fdreshaj/PCB_DESIGN_WORKSHOP_STM32/layout.pdf

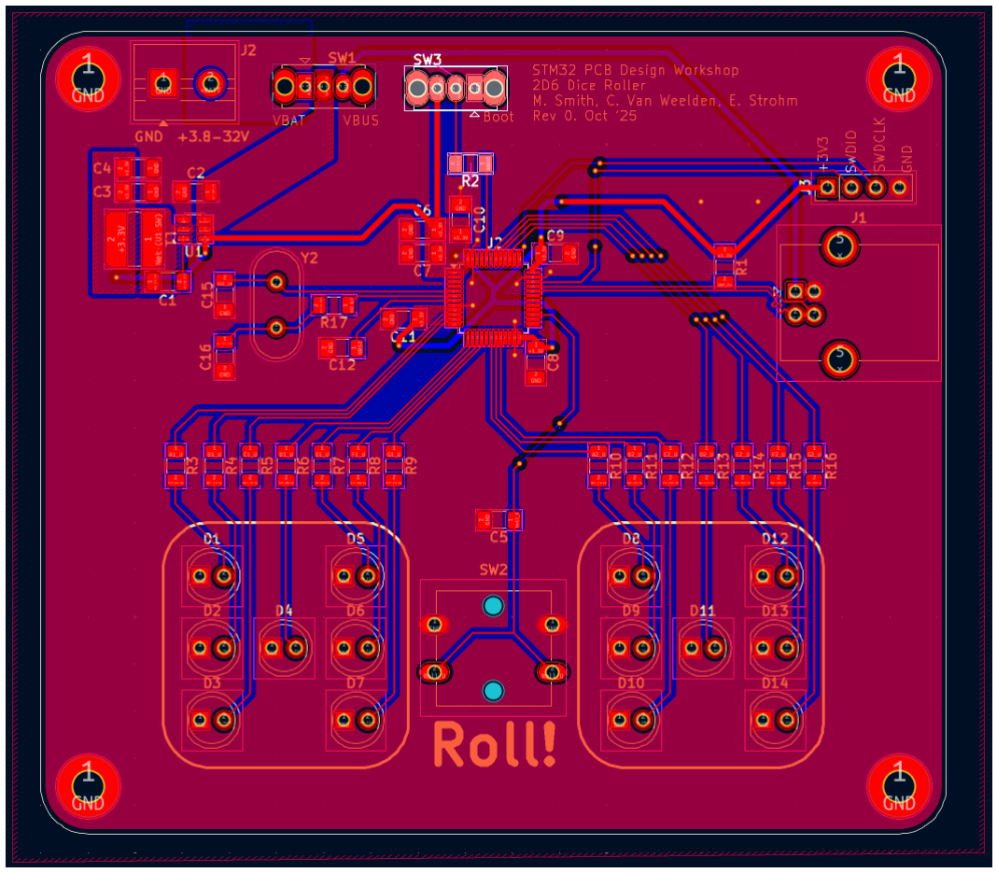
[picture p1: figure]
