fdreshaj/PCB_DESIGN_WORKSHOP_STM32/Layout Reference Guide Updated (1).pdf

# Layout Reference Guide

Before moving onto layout, make sure all your symbols have an assigned footprint.

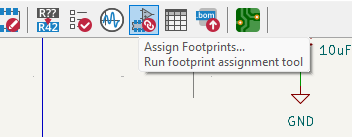
[picture p2: figure]

Your Assignments should look something similar to this, a symbol should have a matching footprint, check the given STM32_PCB_Workshop_Design.xlsx for finding
the right footprints. You should not need to import any symbol or footprint for this project.

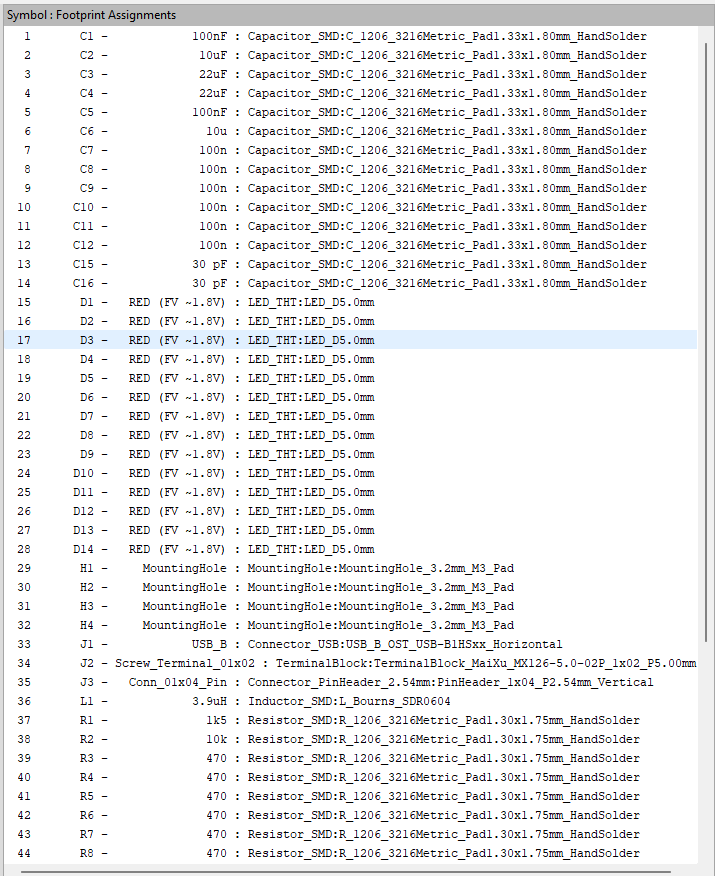
[picture p3: figure]

When you go through assigning footprints, make sure you are copying the footprint associated with the right value instead of the Reference number, since your placement might have different numbers.

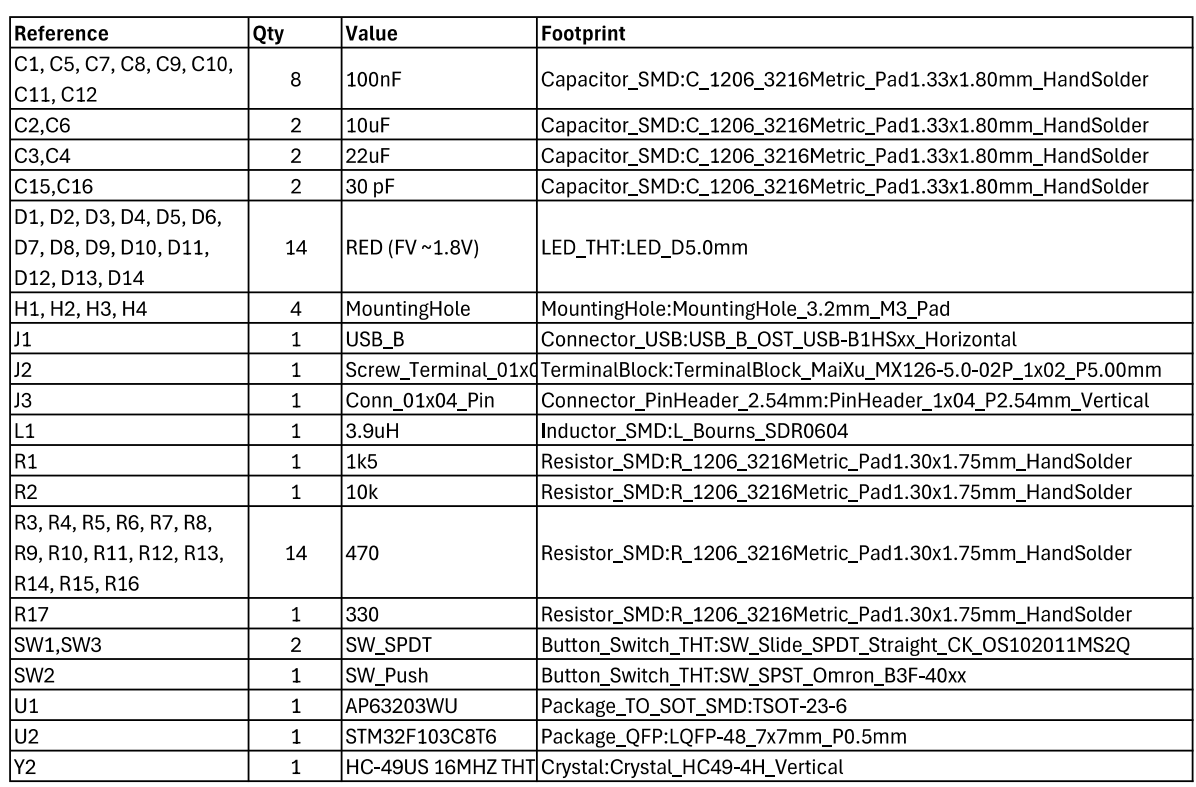
[picture p4: figure]
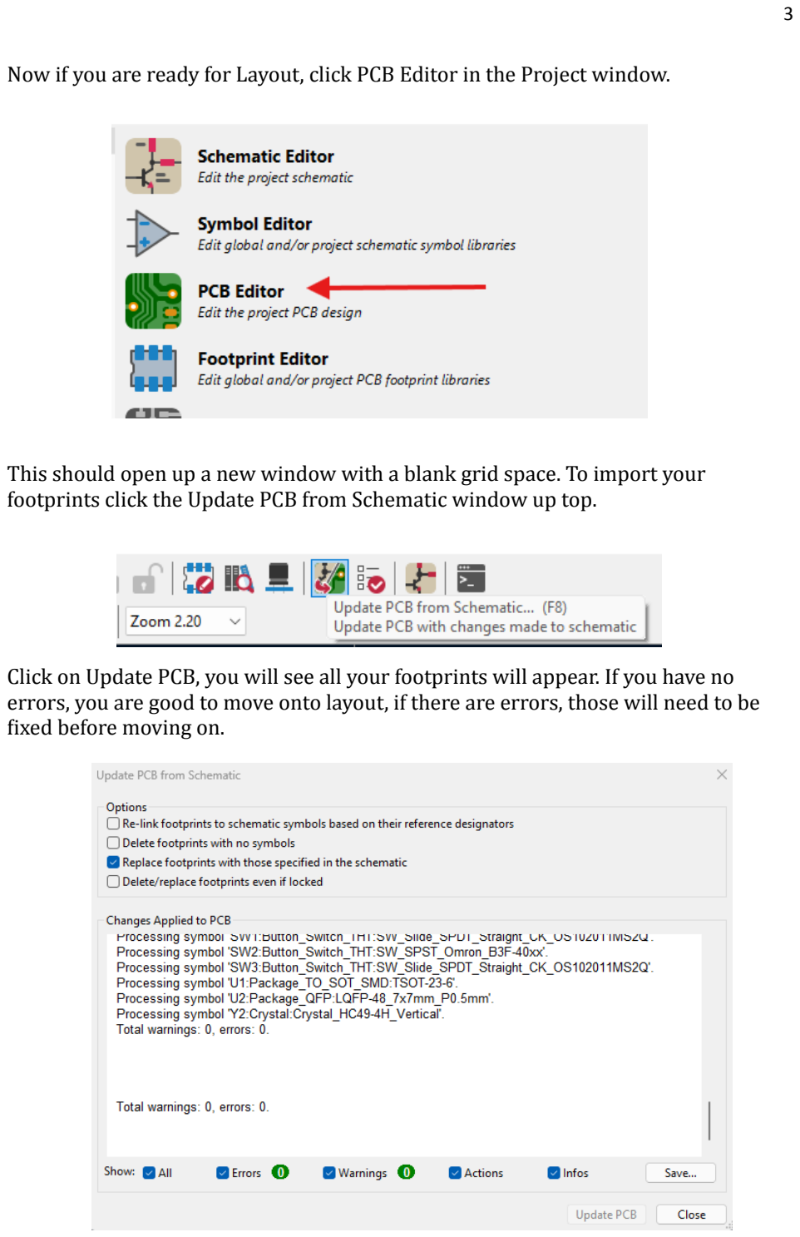
[picture p5: page 3]

Now if you are ready for Layout, click PCB Editor in the Project window.

This should open up a new window with a blank grid space. To import your footprints click the Update PCB from Schematic window up top.

Click on Update PCB, you will see all your footprints will appear. If you have no errors, you are good to move onto layout, if there are errors, those will need to be fixed before moving on.

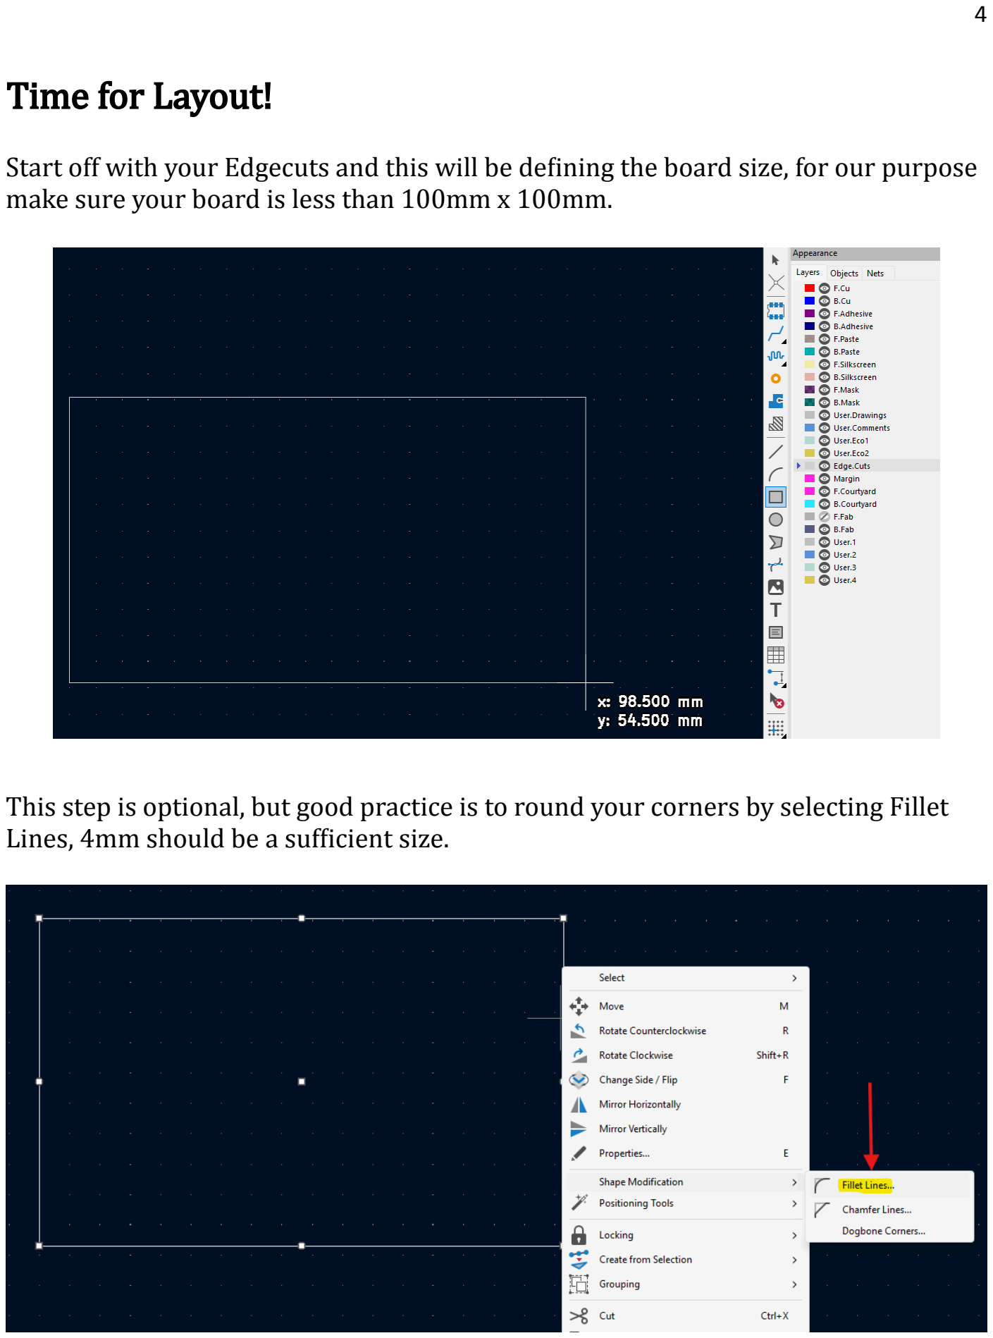
[picture p6: page 4]

Time for Layout!

Start off with your Edgecuts and this will be defining the board size, for our purpose make sure your board is less than 100mm x 100mm.

This step is optional, but good practice is to round your corners by selecting Fillet Lines, 4mm should be a sufficient size.

One last thing before we start connecting all of our components is to either define your netclasses or make Pre-defined Sizes. The point of this is to set what our trace widths need to be for certain connections, for most signal lines, having the default value of 0.2mm will be sufficient. However for power sections, or areas with a high amount of current flowing through we want thicker traces.

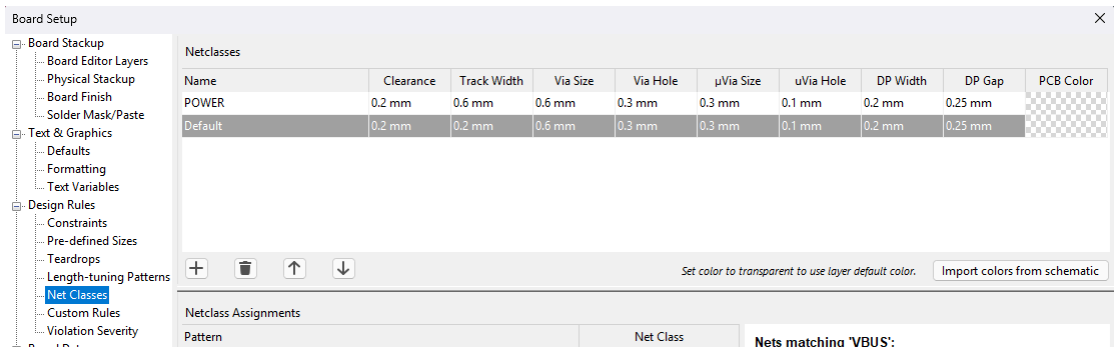
[picture p7: figure]
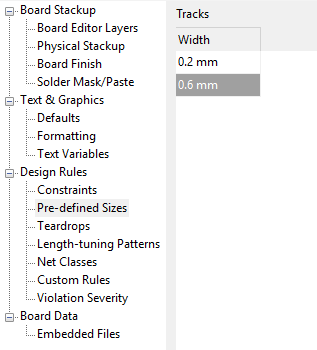
[picture p8: figure]
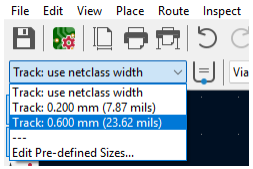
[picture p9: figure]

If you are interested in knowing the exact value to choose for trace widths, DigiKey
has a calculator reference: PCB Trace Width Conversion Calculator | DigiKey (https://www.digikey.com/en/resources/conversion-calculators/conversion-calculator-pcb-trace-width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)

General rule of thumb is go as thick as you can for known high current traces.

Reference Layout

At this point, you have the freedom of laying out the components however you would like. There are some general guidelines in layout we recommend to prevent signal integrity issues, performance, and easier chance of soldering components(keep in mind you will end up soldering these components yourself, make your job as easy as possible)

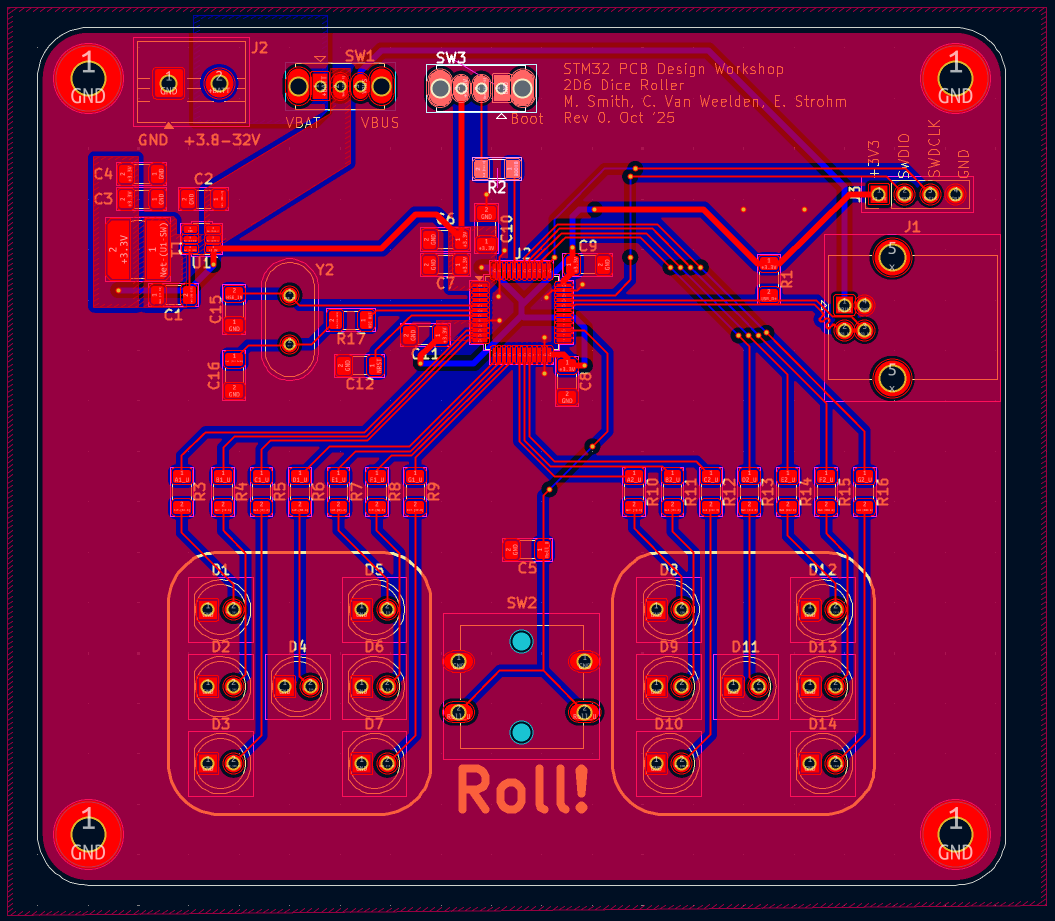
[picture p10: figure]

If unsure where to start placing components. Here is our reference design to get started.

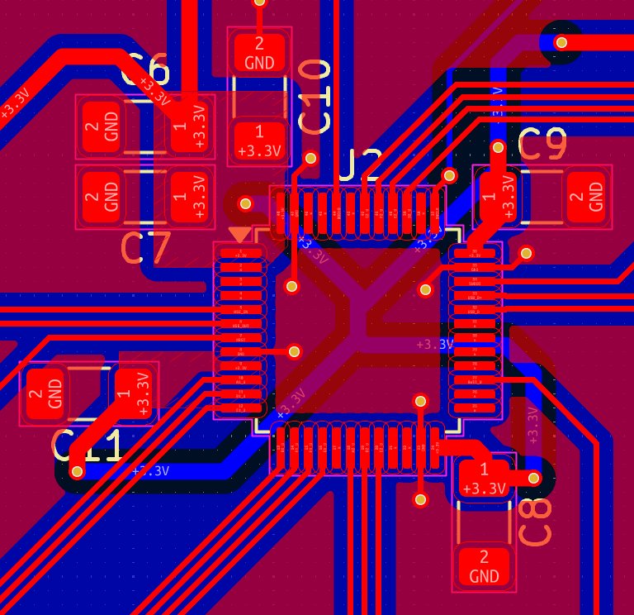
[picture p11: figure]

In most designs, you want to start off with your MCU(Micro Controller Unit) in our case is the STM32 board. This will usually be in the center of the board for options in routing our signal lines. Make sure your decoupling caps (C6,C7,C8,C9,C10,C11) are close to the +3.3V lines of your MCU.

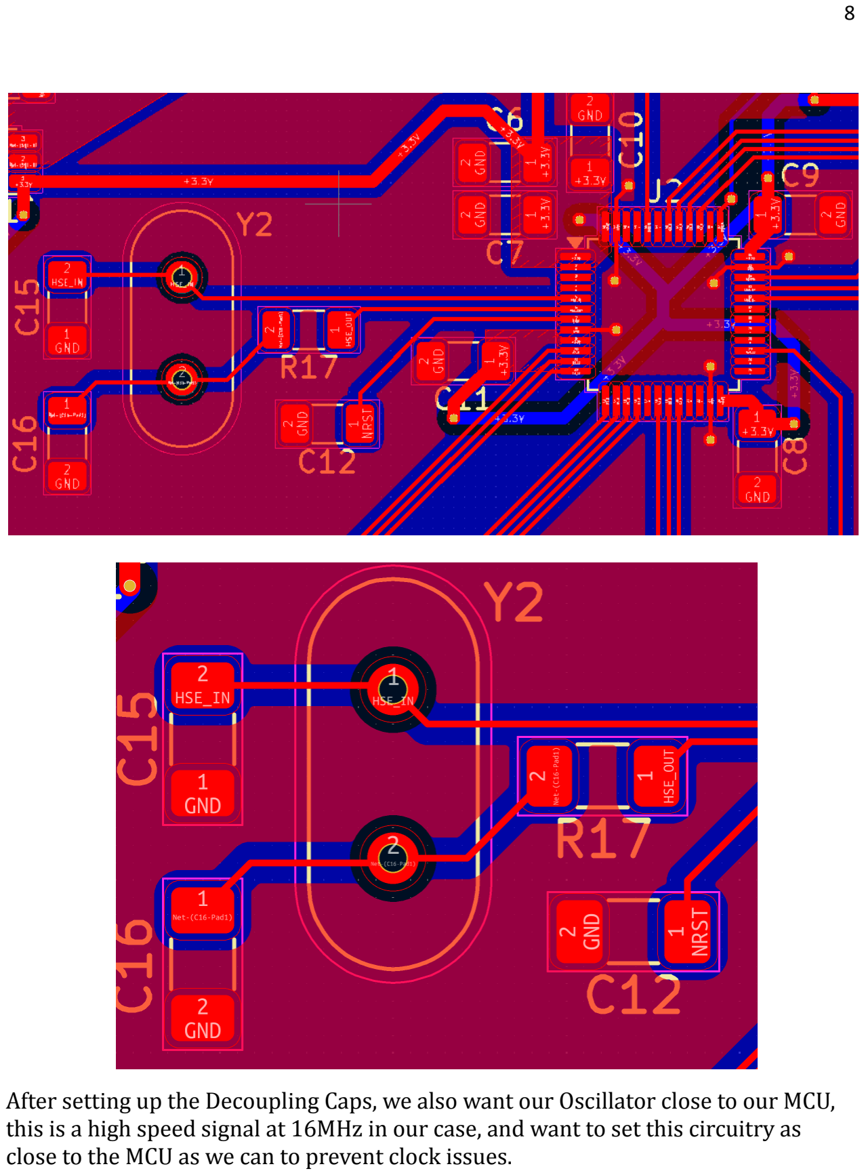
[picture p12: page 8]

After setting up the Decoupling Caps, we also want our Oscillator close to our MCU, this is a high speed signal at 16MHz in our case, and want to set this circuitry as close to the MCU as we can to prevent clock issues.

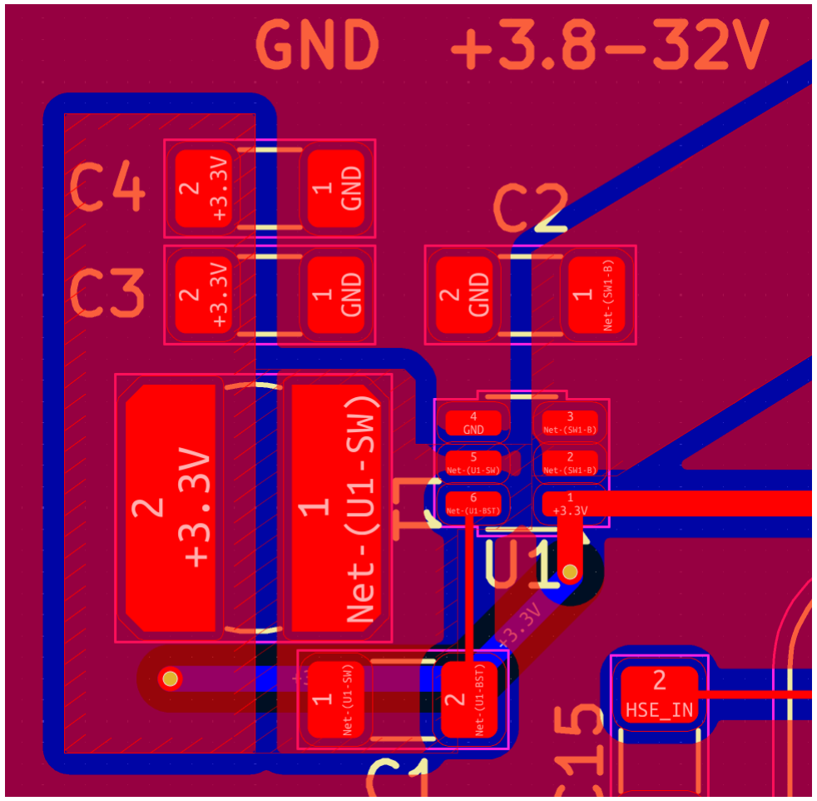
[picture p13: figure]

Next we can set up the Switching Regulator, again, this layout is based on this recommended datasheet layout from AP63203WU. Something to note is that this Switching regulator is switching around 1.1MHZ and should be put further away from the crystal oscillator if you can or other high speed circuitry.

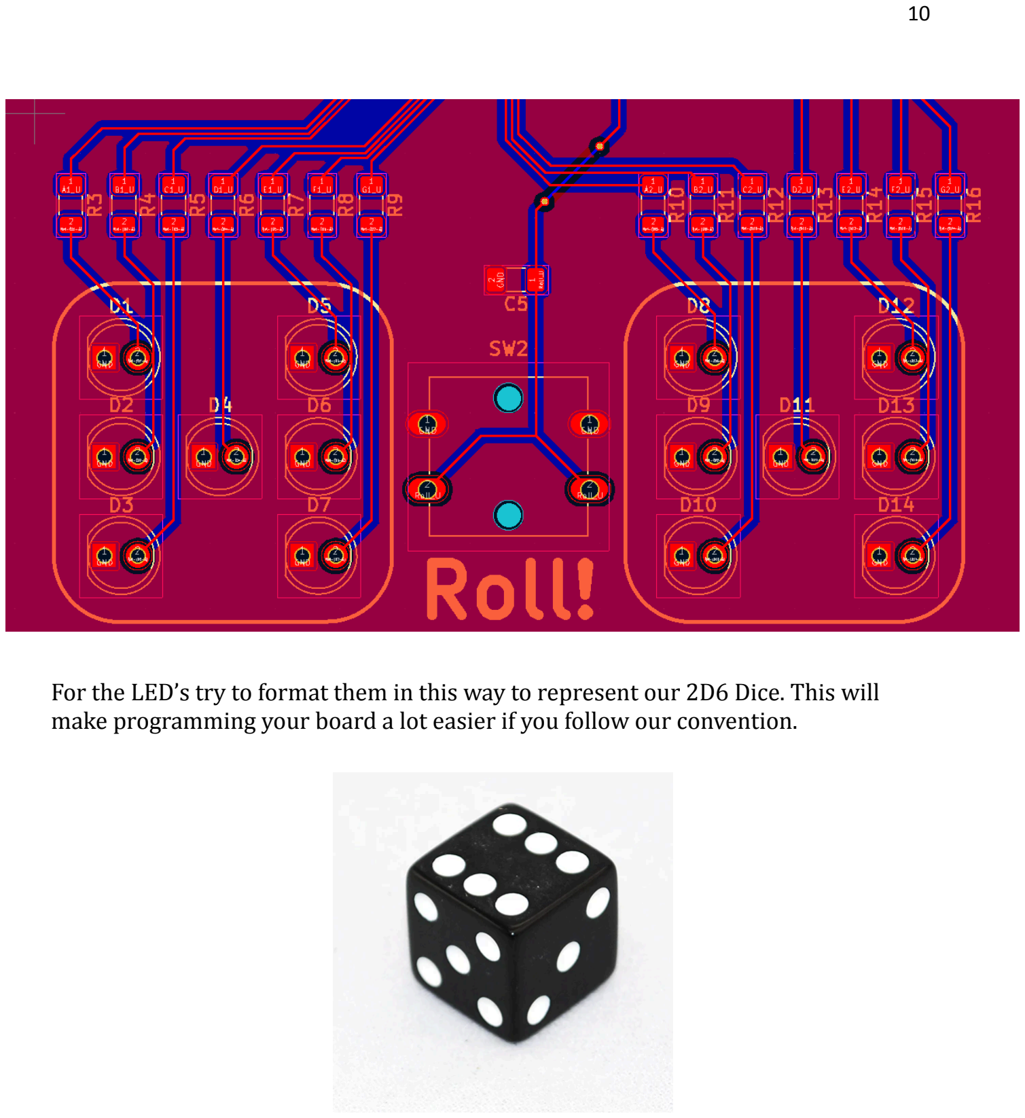
[picture p14: page 10]

For the LED’s try to format them in this way to represent our 2D6 Dice. This will make programming your board a lot easier if you follow our convention.

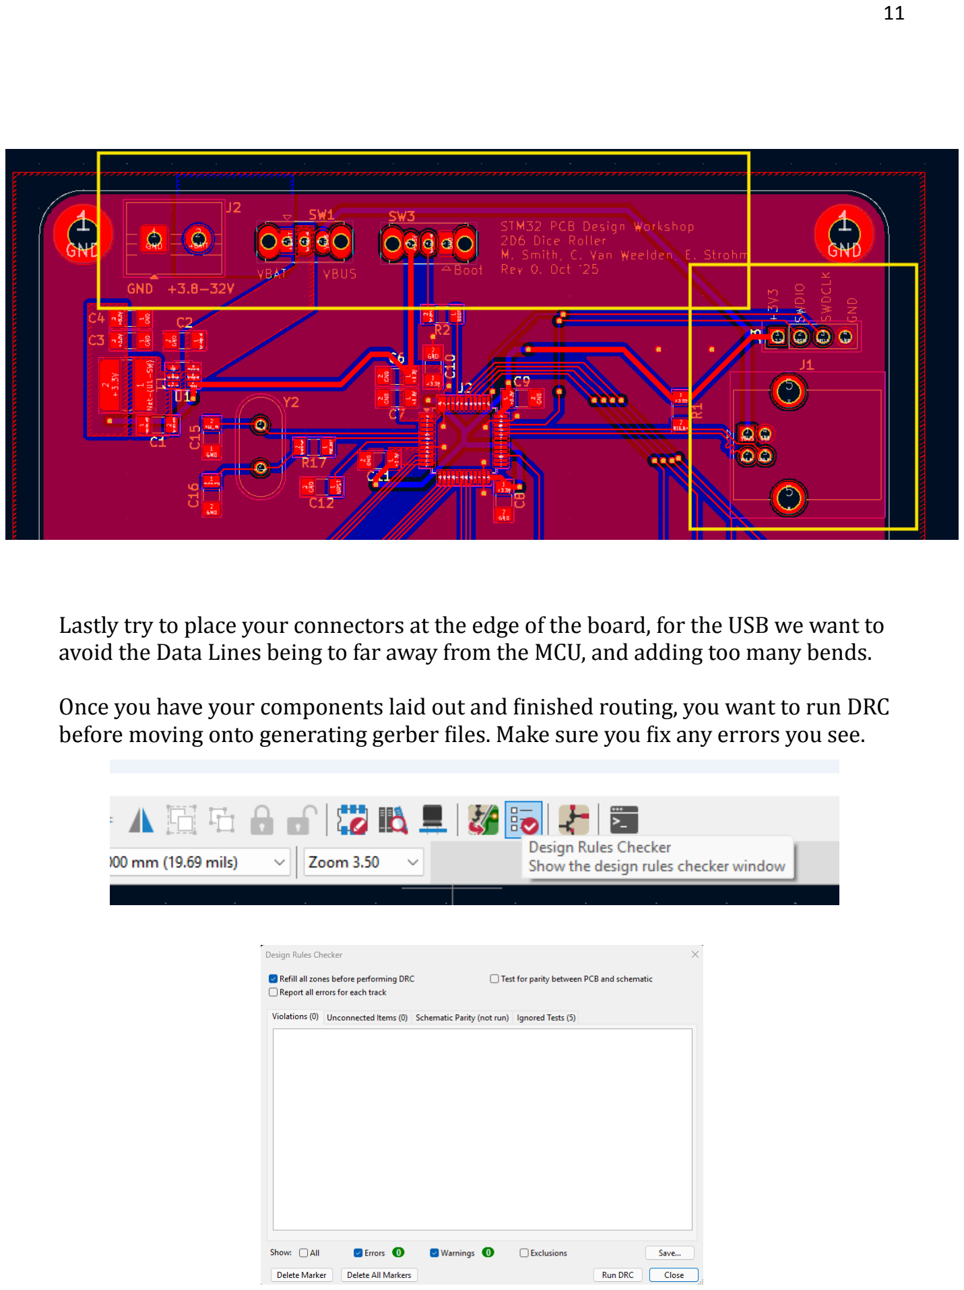
[picture p15: page 11]

Lastly try to place your connectors at the edge of the board, for the USB we want to avoid the Data Lines being to far away from the MCU, and adding too many bends.

Once you have your components laid out and finished routing, you want to run DRC before moving onto generating gerber files. Make sure you fix any errors you see.

Silk Screen

Once you have all of your routing and electrical connections made, the next step includes adding text to your board and notify important connections. This is done through the silkscreen which will appear on the top of your board, make sure when you are getting ready to add text you select the silkscreen tab. Shown below

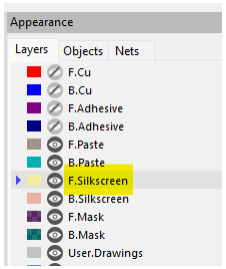
[picture p16: figure]
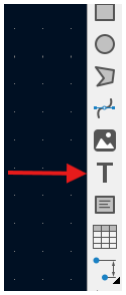
[picture p17: figure]

The silkscreen layer will appear as the yellow text in your PCB editor. Feel free to add any text or design that you would like, but make sure you have the following labeled.

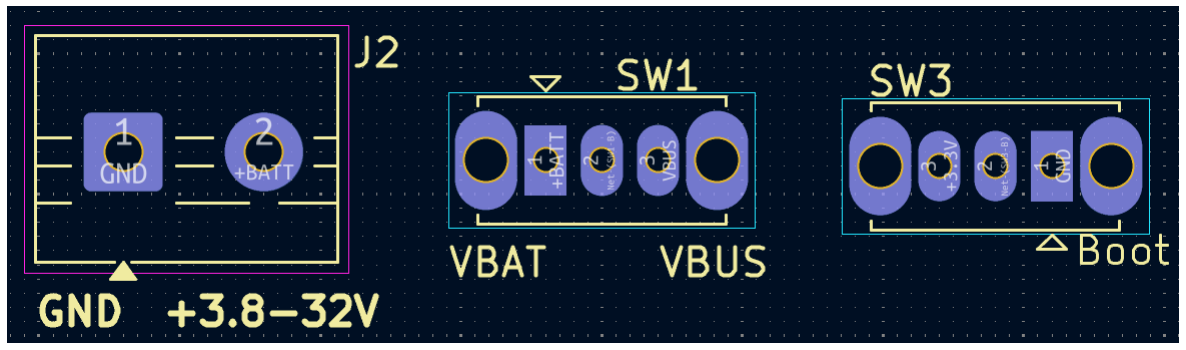
[picture p18: figure]

Make sure to include the polarity of 9V battery terminal shown in J2 symbol, adding this prevents easy mistakes of reverse polarity issues when board is finally assembled

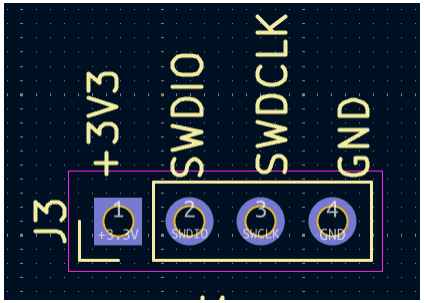
[picture p19: figure]

The other important component is to label the SWD pinout shown above.

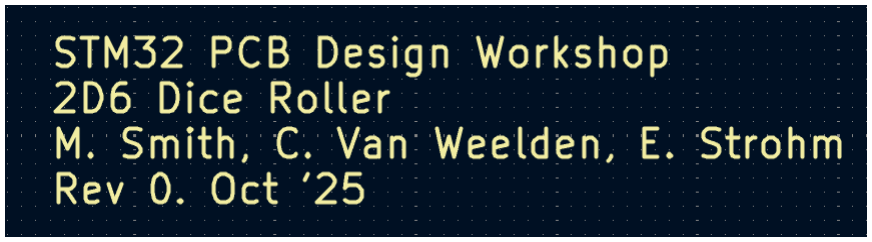
[picture p20: figure]

Lastly make sure to include the title of your board and your name to show off at future career fairs!

Gerber File & Submission:

Now that your board has passed ERC and DRC without any issues, we can move onto fabricating your board! Click on File -> Fabrication Outputs -> Gerbers. This will take you to a window, I would recommend following the layout shown in the figure below and Generate your Drill Files and Gerbers in the Same Folder

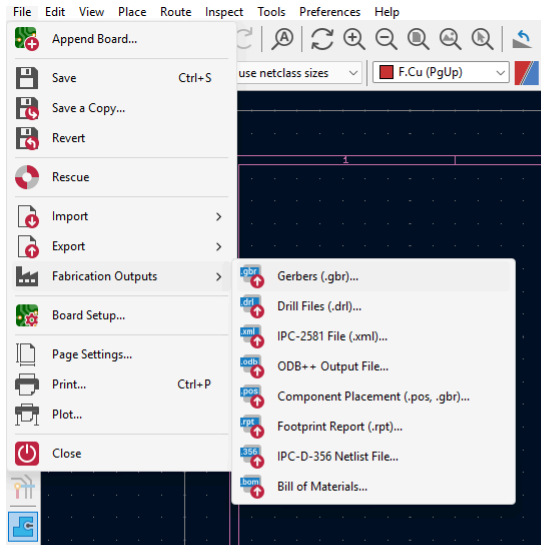
[picture p21: figure]
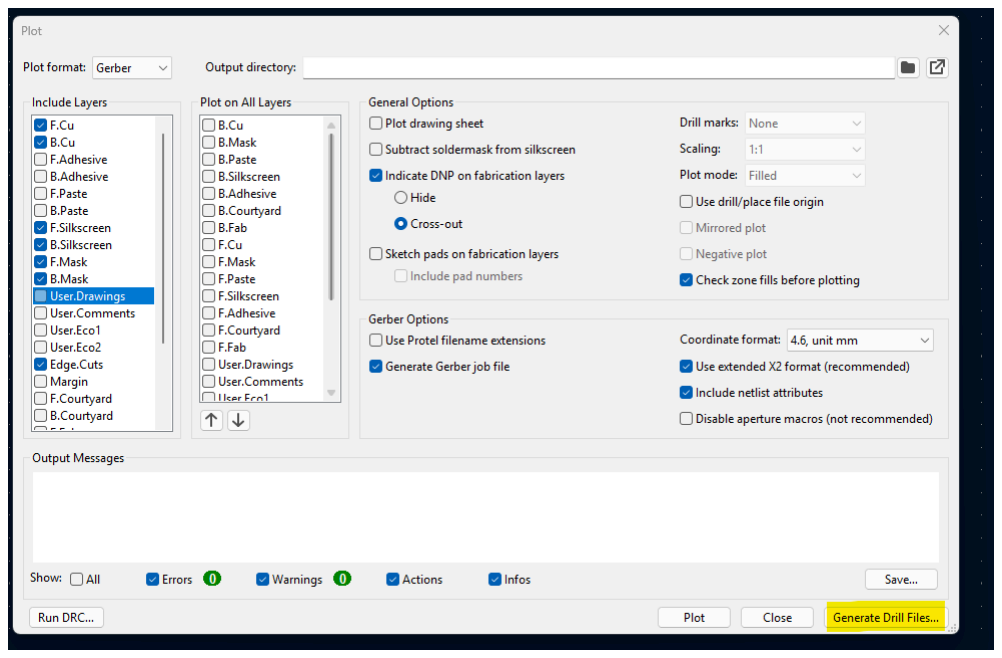
[picture p22: figure]

For your board to be fabricated We need a Zip file from you and should include the following:
- Your KiCAD Project with your Schematic(kicad_sch) and Layout(kicad_pcb)
- Your Gerber and Drill Files
- Title your Zip Folder your First and Last Name

Email your zip file to mss3247@iastate.edu
