fdreshaj/PCB_DESIGN_WORKSHOP_STM32/STM32_PCB_Workshop_Design/STM32_PCB_Workshop_Design.pdf

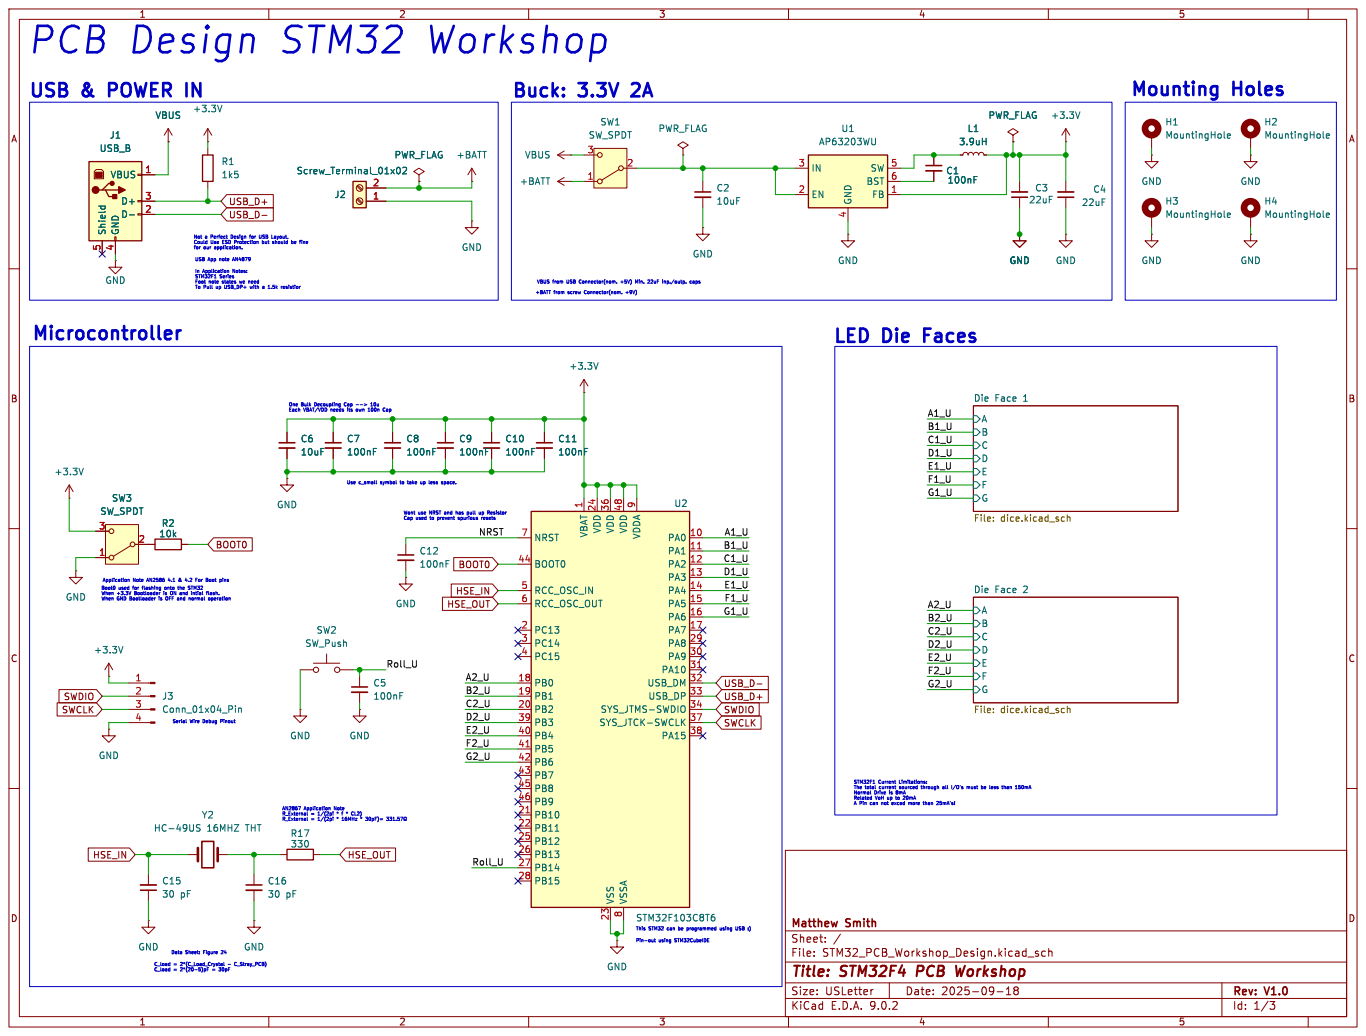
[picture p23: page 1]

4 SW 5 BST 6 FB 1 U1 AP63203WU GND

Die Face 1 File: dice.kicad_sch C2

1 VDD 24 VDD 36 VSS 23 VDD 48 VSSA
NRST E2_U

File: STM32_PCB_Workshop_Design.kicad_sch Sheet: / Matthew Smith

Id: 1/3 Title: STM32F4 PCB Workshop

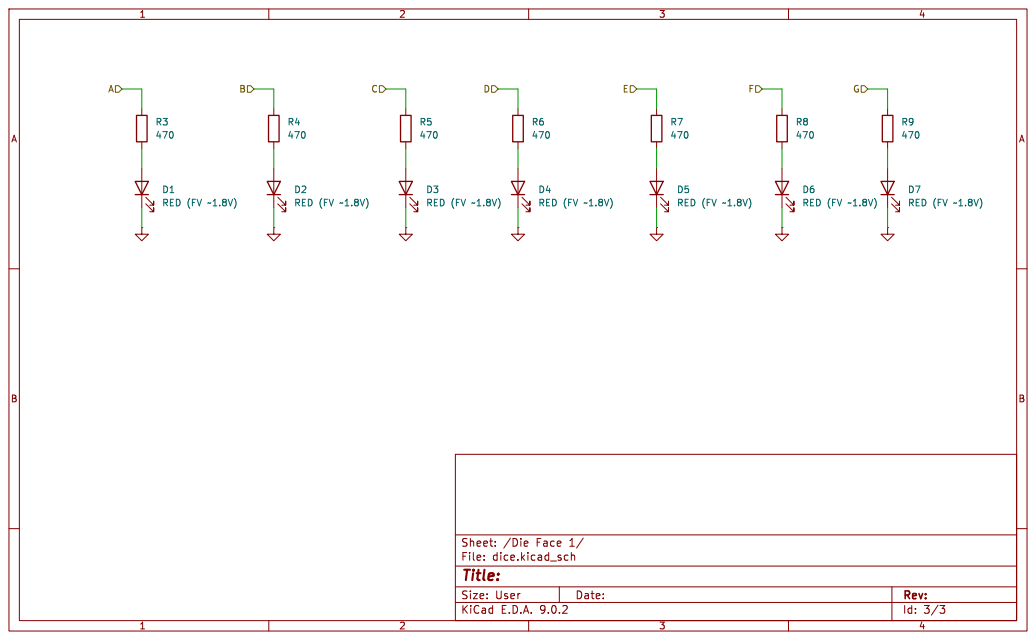
[picture p24: page 2]

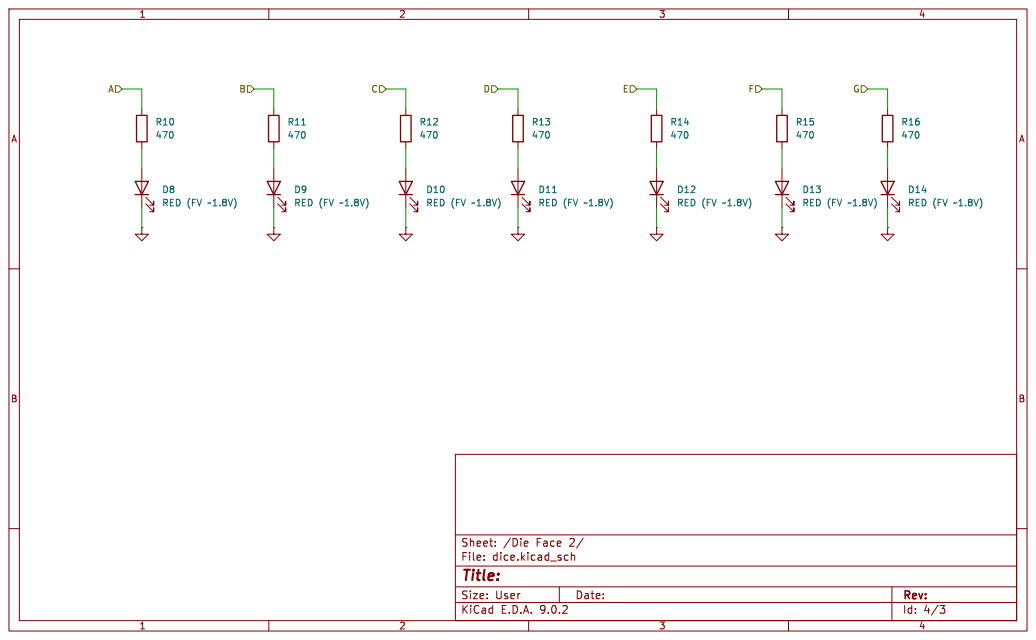
[picture p25: page 3]

470 D11 RED (FV ~1.8V) D8 RED (FV ~1.8V) R10
