fdreshaj/PCB_DESIGN_WORKSHOP_STM32/STM32_Schematic.pdf

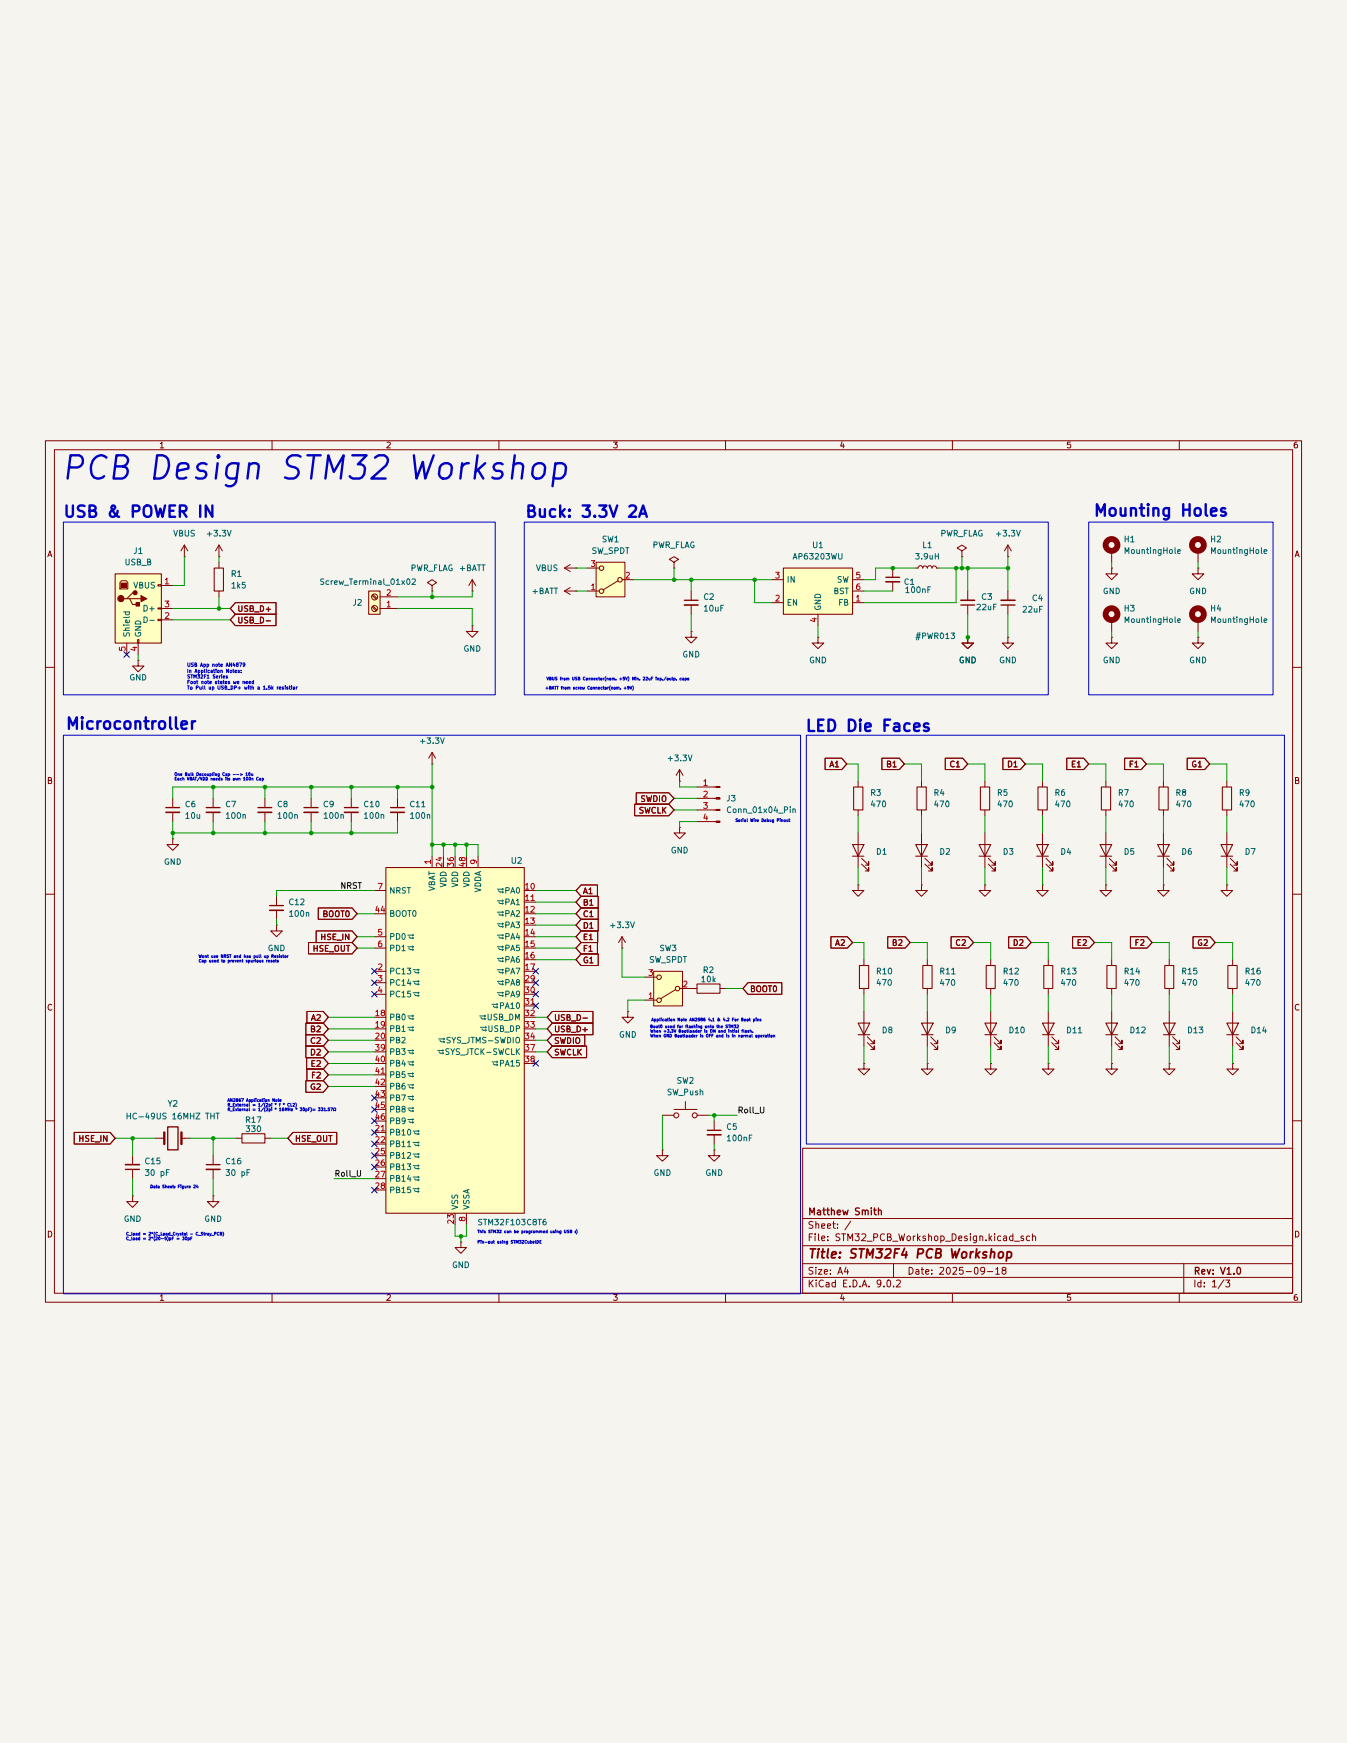
[picture p27: page 1]

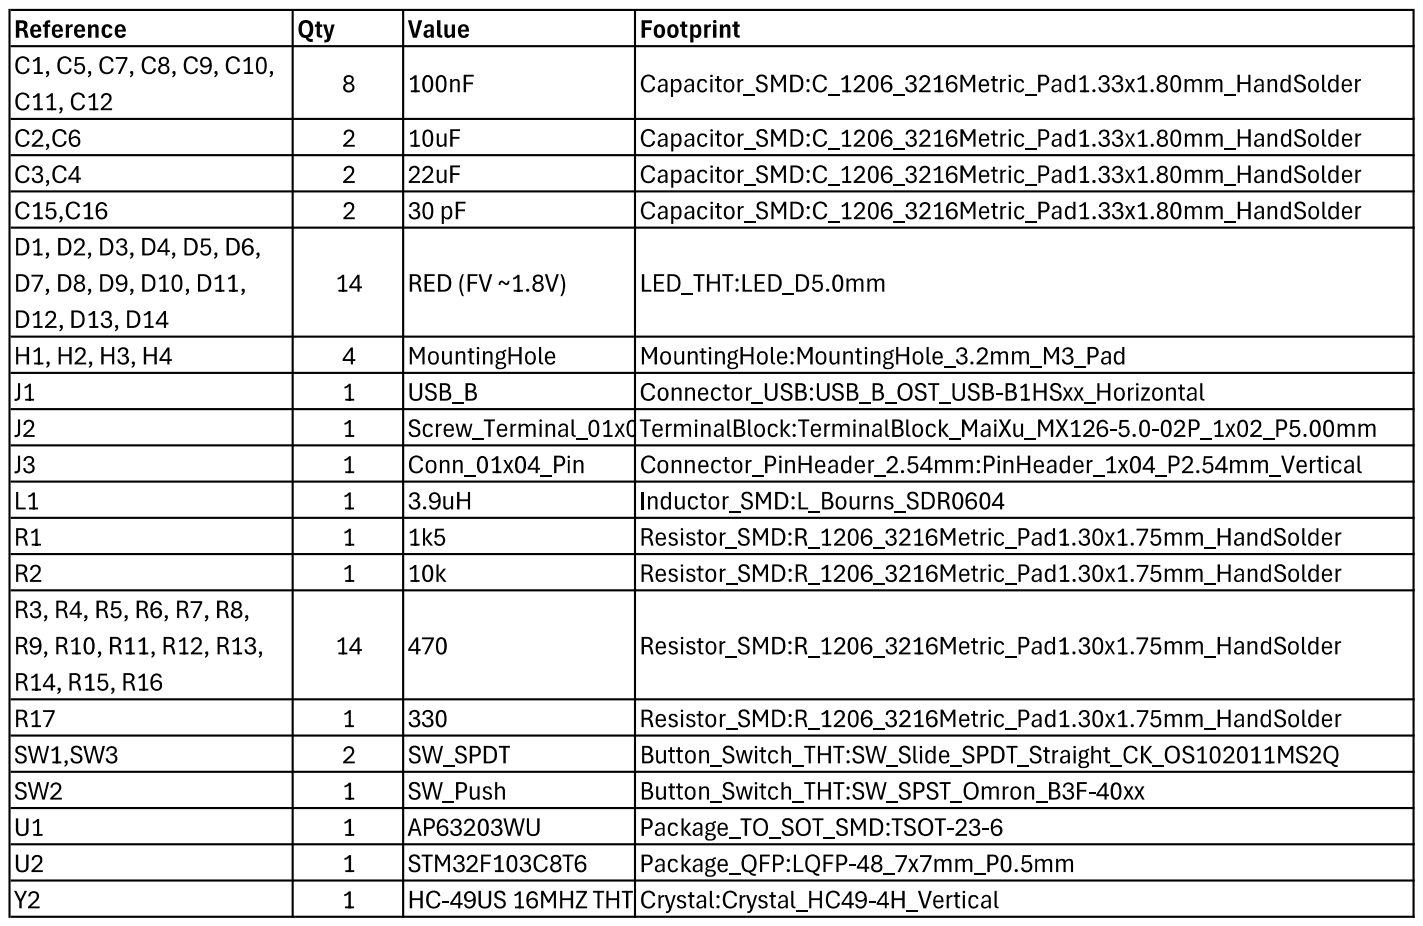
[picture p28: page 2]
