fdreshaj/PCB_DESIGN_WORKSHOP_STM32/STM32_PCB_Workshop_Design/STM32_PCB_Workshop_Design.kicad_pcb

## KiCad design STM32_PCB_Workshop_Design/STM32_PCB_Workshop_Design.kicad_pcb (2025-10-19)

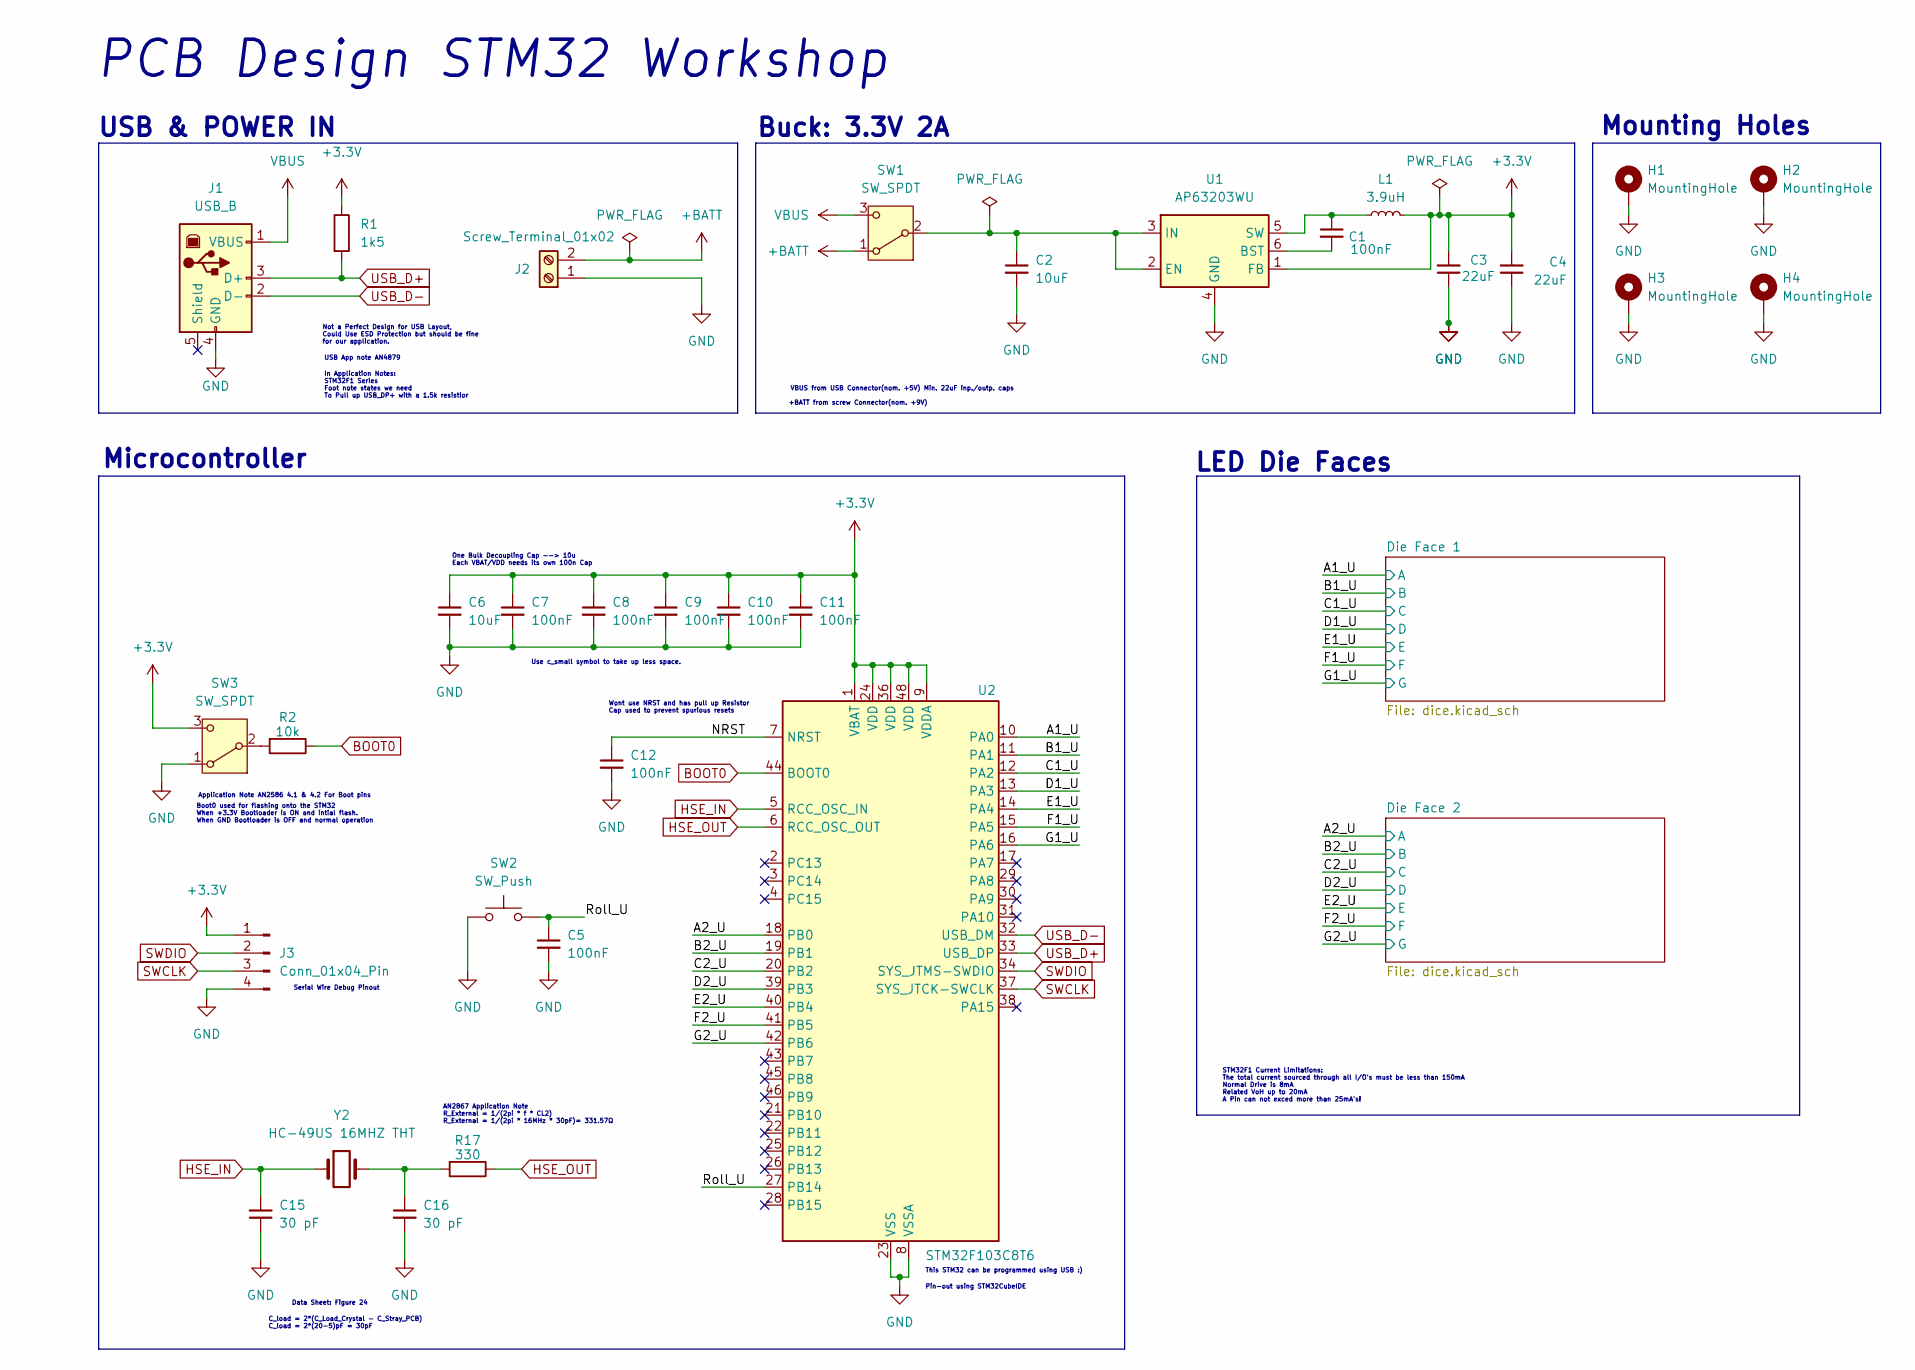
[picture p29: schematic STM32_PCB_Workshop_Design.kicad_sch, STM32F4 PCB Workshop]

Parts:
C1, C5, C7, C8, C9, C10, C11, C12: 100nF; C_1206_3216Metric_Pad1.33x1.80mm_HandSolder
C2, C6: 10uF; C_1206_3216Metric_Pad1.33x1.80mm_HandSolder
C3, C4: 22uF; C_1206_3216Metric_Pad1.33x1.80mm_HandSolder
C15, C16: 30 pF; C_1206_3216Metric_Pad1.33x1.80mm_HandSolder
H1, H2, H3, H4: MountingHole; MountingHole_3.2mm_M3_Pad
J1: USB_B; USB_B_OST_USB-B1HSxx_Horizontal
J2: Screw_Terminal_01x02; TerminalBlock_MaiXu_MX126-5.0-02P_1x02_P5.00mm
J3: Conn_01x04_Pin; PinHeader_1x04_P2.54mm_Vertical
L1: 3.9uH; L_Bourns_SDR0604
R1: 1k5; R_1206_3216Metric_Pad1.30x1.75mm_HandSolder
R2: 10k; R_1206_3216Metric_Pad1.30x1.75mm_HandSolder
R17: 330; R_1206_3216Metric_Pad1.30x1.75mm_HandSolder
SW1, SW3: SW_SPDT; SW_Slide_SPDT_Straight_CK_OS102011MS2Q
SW2: SW_Push; SW_SPST_Omron_B3F-40xx
U1: AP63203WU; TSOT-23-6
U2: STM32F103C8T6; LQFP-48_7x7mm_P0.5mm
Y2: HC-49US 16MHZ THT; Crystal_HC49-4H_Vertical

Connections:
+3.3V: C3.2, C4.2, C6.1, C7.1, C8.1, C9.1, C10.1, C11.1, J3.1, L1.2, R1.1, SW3.3 (C), U1.1 (FB), U2.1 (VBAT), U2.9 (VDDA), U2.24 (VDD), U2.36 (VDD), U2.48 (VDD)
+BATT: J2.2, SW1.1 (A)
/A1_U: U2.10 (PA0); also elsewhere on the board
/A2_U: U2.18 (PB0); also elsewhere on the board
/B1_U: U2.11 (PA1); also elsewhere on the board
/B2_U: U2.19 (PB1); also elsewhere on the board
/C1_U: U2.12 (PA2); also elsewhere on the board
/C2_U: U2.20 (PB2); also elsewhere on the board
/D1_U: U2.13 (PA3); also elsewhere on the board
/D2_U: U2.39 (PB3); also elsewhere on the board
/E1_U: U2.14 (PA4); also elsewhere on the board
/E2_U: U2.40 (PB4); also elsewhere on the board
/F1_U: U2.15 (PA5); also elsewhere on the board
/F2_U: U2.41 (PB5); also elsewhere on the board
/G1_U: U2.16 (PA6); also elsewhere on the board
/G2_U: U2.42 (PB6); also elsewhere on the board
/NRST: C12.1, U2.7 (NRST)
/Roll_U: C5.1, SW2.2, U2.27 (PB14)
BOOT0: R2.1, U2.44 (BOOT0)
GND: C2.2, C3.1, C4.1, C5.2, C6.2, C7.2, C8.2, C9.2, C10.2, C11.2, C12.2, C15.1, C16.2, H1.1, H2.1, H3.1, H4.1, J1.4 (GND), J2.1, J3.4, SW2.1, SW3.1 (A), U1.4 (GND), U2.8 (VSSA), U2.23 (VSS), U2.35 (VSS), U2.47 (VSS); also elsewhere on the board
HSE_IN: C15.2, U2.5 (PD0), Y2.1
HSE_OUT: R17.1, U2.6 (PD1)
unnamed: C16.1, R17.2, Y2.2
unnamed: C2.1, SW1.2 (B), U1.2 (EN), U1.3 (IN)
unnamed: R2.2, SW3.2 (B)
unnamed: C1.2, U1.6 (BST)
unnamed: C1.1, L1.1, U1.5 (SW)
SWCLK: J3.3, U2.37 (SYS_JTCK-SWCLK)
SWDIO: J3.2, U2.34 (SYS_JTMS-SWDIO)
USB_D+: J1.3 (D+), R1.2, U2.33 (USB_DP)
USB_D-: J1.2 (D-), U2.32 (USB_DM)
VBUS: J1.1 (VBUS), SW1.3 (C)

Notes on the sheet:
VBUS from USB Connector(nom. +5V) Min. 22uF inp./outp. caps
USB & POWER IN
PCB Design STM32 Workshop
USB App note AN4879
In Application Notes: STM32F1 Series Foot note states we need To Pull up USB_DP+ with a 1.5k resistior
This STM32 can be programmed using USB :)
+BATT from screw Connector(nom. +9V)
LED Die Faces
AN2867 Application Note R_External = 1/(2pi * f * CL2) R_External = 1/(2pi * 16MHz * 30pF)= 331.57Ω
C_load = 2*(C_Load_Crystal - C_Stray_PCB) C_load = 2*(20-5)pF = 30pF
Use c_small symbol to take up less space.
Mounting Holes
One Bulk Decoupling Cap --> 10u Each VBAT/VDD needs its own 100n Cap
Wont use NRST and has pull up Resistor Cap used to prevent spurious resets
Pin-out using STM32CubeIDE
Not a Perfect Design for USB Layout, Could Use ESD Protection but should be fine for our application.
Data Sheet: Figure 24
Buck: 3.3V 2A
Microcontroller
STM32F1 Current Limitations: The total current sourced through all I/O's must be less than 150mA Normal Drive is 8mA Related VoH up to 20mA A Pin can not exced more than 25mA's!
Boot0 used for flashing onto the STM32 When +3.3V Bootloader is ON and intial flash. When GND Bootloader is OFF and normal operation
Serial Wire Debug Pinout
Application Note AN2586 4.1 & 4.2 For Boot pins

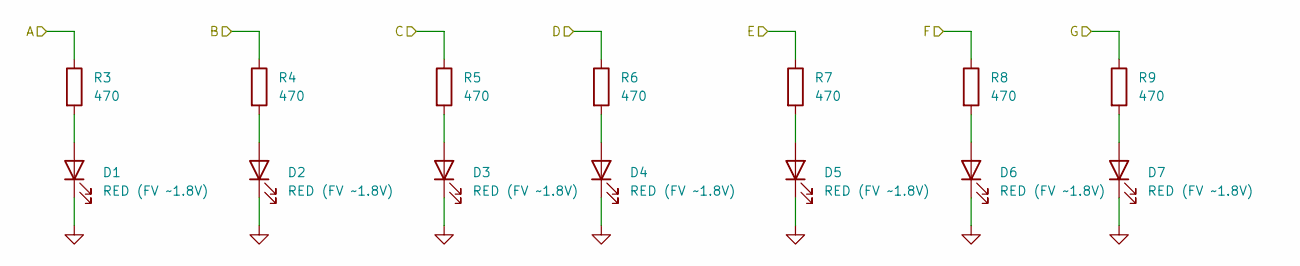
[picture p30: schematic dice.kicad_sch]

Parts:
D1, D2, D3, D4, D5, D6, D7: RED (FV ~1.8V); LED_D5.0mm
R3, R4, R5, R6, R7, R8, R9: 470; R_1206_3216Metric_Pad1.30x1.75mm_HandSolder

Connections:
/A1_U: R3.1; also elsewhere on the board
/B1_U: R4.1; also elsewhere on the board
/C1_U: R5.1; also elsewhere on the board
/D1_U: R6.1; also elsewhere on the board
/E1_U: R7.1; also elsewhere on the board
/F1_U: R8.1; also elsewhere on the board
/G1_U: R9.1; also elsewhere on the board
GND: D1.1 (K), D2.1 (K), D3.1 (K), D4.1 (K), D5.1 (K), D6.1 (K), D7.1 (K); also elsewhere on the board
unnamed: D1.2 (A), R3.2
unnamed: D2.2 (A), R4.2
unnamed: D3.2 (A), R5.2
unnamed: D4.2 (A), R6.2
unnamed: D5.2 (A), R7.2
unnamed: D6.2 (A), R8.2
unnamed: D7.2 (A), R9.2

Parts of its further copies:
D8, D9, D10, D11, D12, D13, D14: RED (FV ~1.8V); LED_D5.0mm
R10, R11, R12, R13, R14, R15, R16: 470; R_1206_3216Metric_Pad1.30x1.75mm_HandSolder

Connections of its further copies:
/A2_U: R10.1; also elsewhere on the board
/B2_U: R11.1; also elsewhere on the board
/C2_U: R12.1; also elsewhere on the board
/D2_U: R13.1; also elsewhere on the board
/E2_U: R14.1; also elsewhere on the board
/F2_U: R15.1; also elsewhere on the board
/G2_U: R16.1; also elsewhere on the board
GND: D8.1 (K), D9.1 (K), D10.1 (K), D11.1 (K), D12.1 (K), D13.1 (K), D14.1 (K); also elsewhere on the board
unnamed: D8.2 (A), R10.2
unnamed: D9.2 (A), R11.2
unnamed: D10.2 (A), R12.2
unnamed: D11.2 (A), R13.2
unnamed: D12.2 (A), R14.2
unnamed: D13.2 (A), R15.2
unnamed: D14.2 (A), R16.2

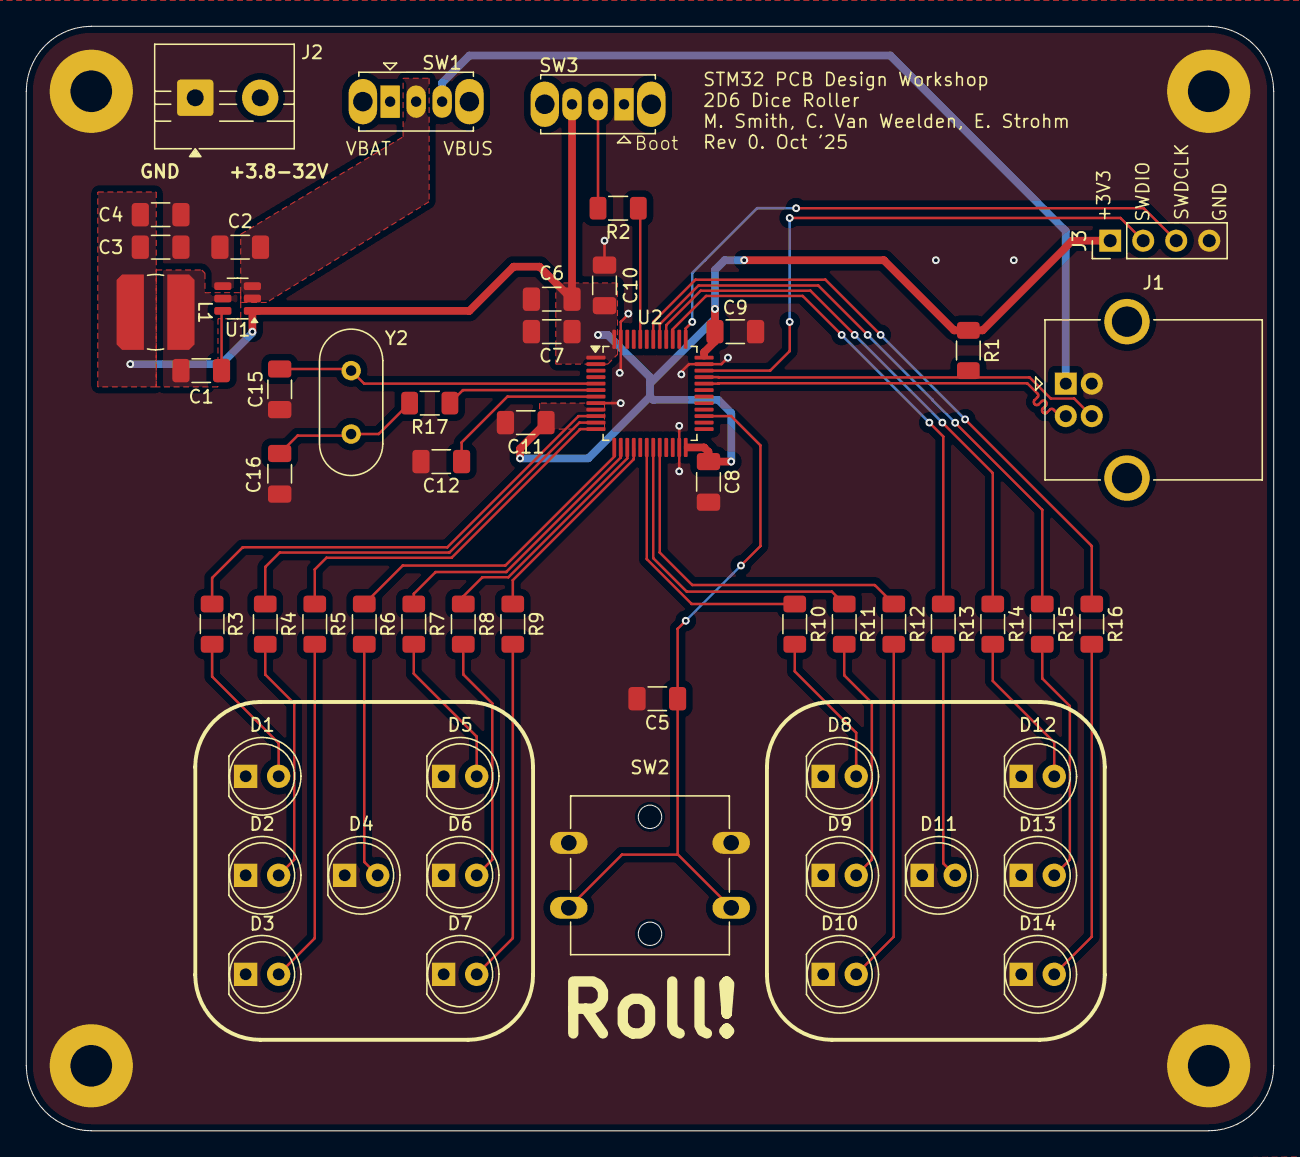
[picture p31: board STM32_PCB_Workshop_Design.kicad_pcb from above]

Board: 2 copper layers, 96.0 x 85.0 mm, 59 parts (0 on the bottom side), 46 nets.
