fdreshaj/PCB_DESIGN_WORKSHOP_STM32/(commit log)

2025-10-19 Add STM32 and KiCad reference PDFs
    Added several application notes and datasheets for STM32 microcontrollers, as well as a KiCad cheatsheet, schematic, and layout PDFs to the repository for hardware and PCB design reference.
2025-10-19 minor changes
    minor changes
    [STM32_PCB_Workshop_Design.kicad_pcb, STM32_PCB_Workshop_Design.kicad_sch, STM32_PCB_Workshop_Design.xlsx, dice.kicad_sch]
